mcranium/MLIC-tools/(commit log)

2023-09-12 Update README.md
    Added wiring diagram to readme
2023-12-19 schematics of the new setup
2024-01-02 Added Arduino script for dome setup
2024-01-02 readme reference to arduino code
